kaminaris/GigaESC-TOLT/3DModels/Infineon-PG-TFLGA-13-1_3D_01_STP-Package-v05_00-EN.stp

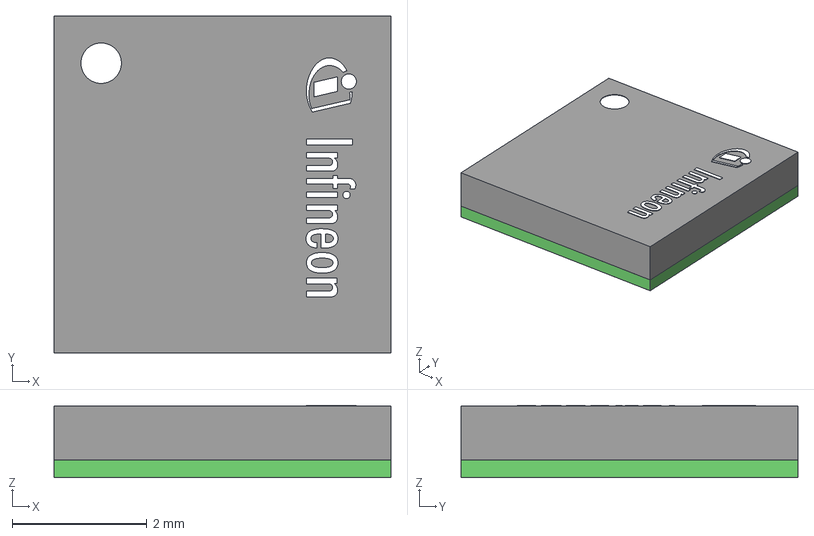
[picture p1: CAD file, 2026-09-26]
3DModels/Infineon-PG-TFLGA-13-1_3D_01_STP-Package-v05_00-EN.stp
5.00 x 5.00 x 1.07 mm
PG-TFLGA-13-1_LOGO
PG-TFLGA-13-1_EXPOSED_LEAD_1
PG-TFLGA-13-1_EXPOSED_LEAD_4
PG-TFLGA-13-1_BOTTOM_SUBSTRATE
