kaminaris/GigaESC-TOLT/3DModels/ACS37030LLZATR-040B3.stp

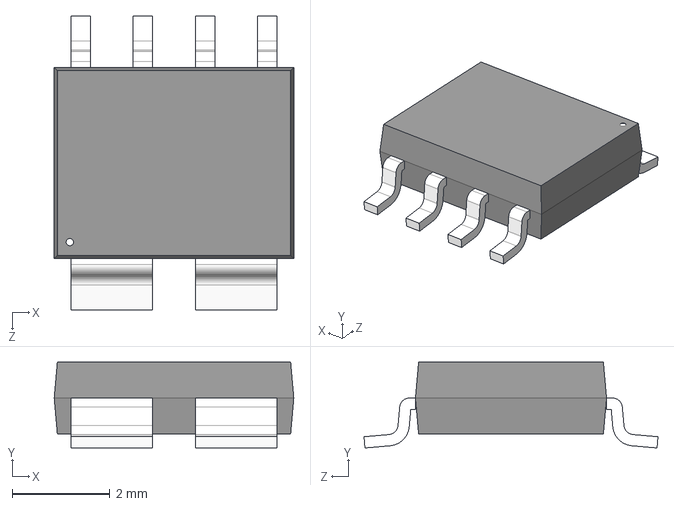
[picture p2: CAD file, 2026-09-26]
3DModels/ACS37030LLZATR-040B3.stp
4.89 x 1.75 x 6.00 mm
