kaminaris/GigaESC-TOLT/GigaTOLT.kicad_pcb

## KiCad design GigaTOLT.kicad_pcb (2026-09-28)

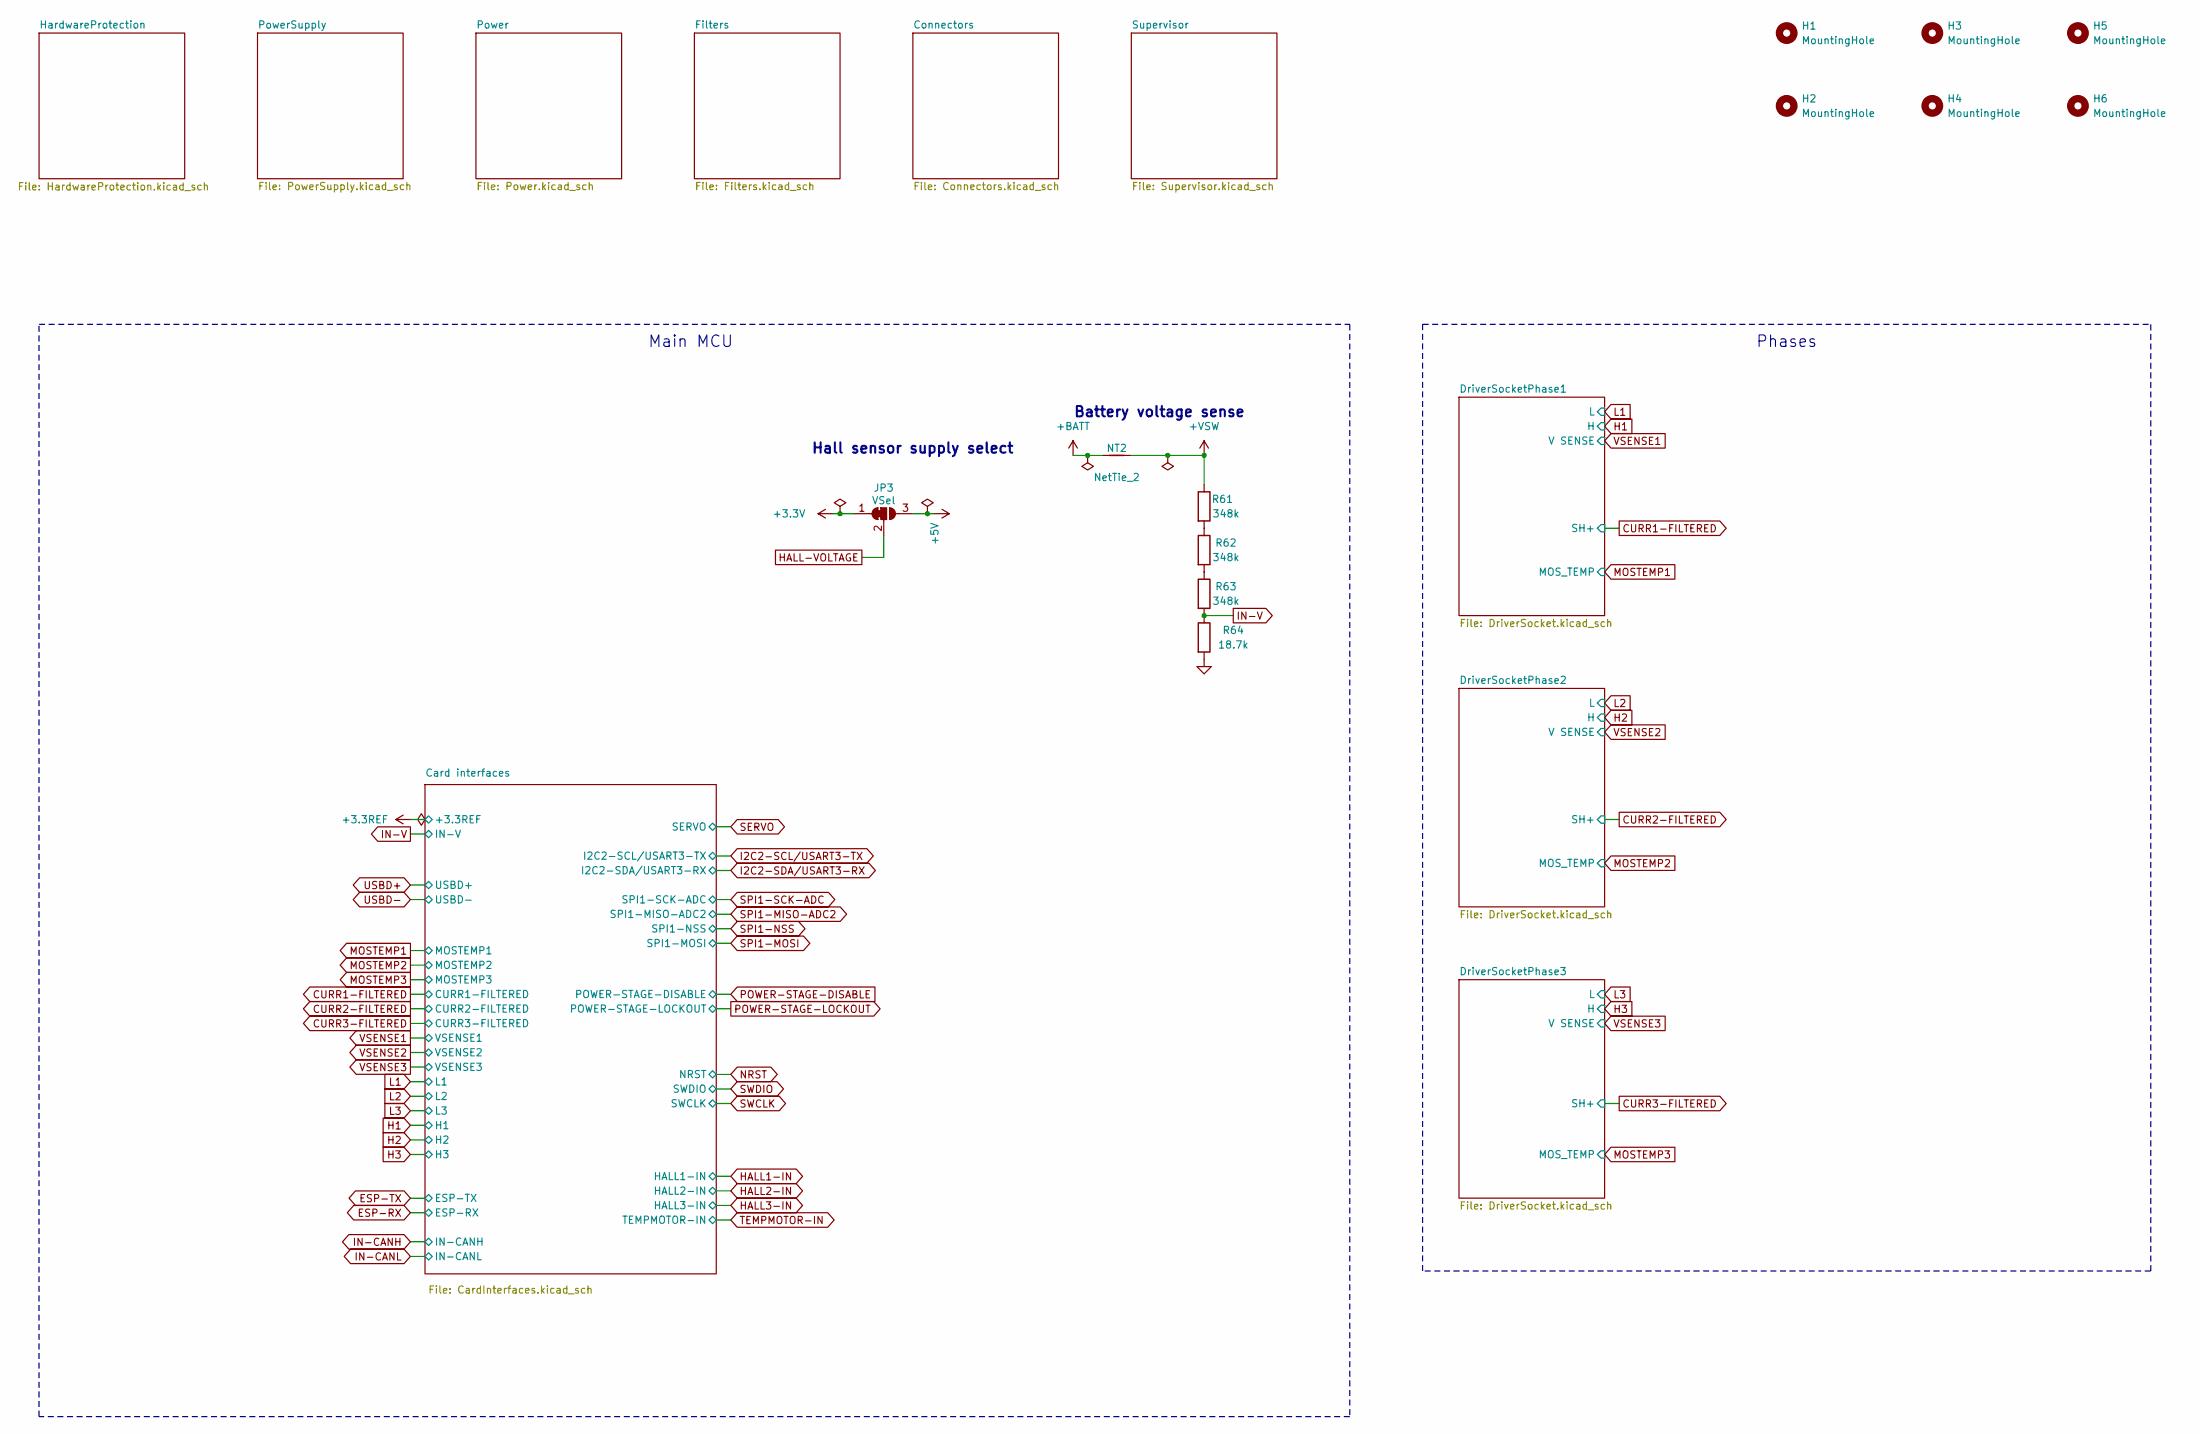
[picture p3: schematic GigaTOLT.kicad_sch]

Parts:
H1, H2, H3, H4, H5, H6: MountingHole; CapHead_3.5mm
JP3: VSel; SolderJumper-3-0.5-Small
NT2: NetTie_2; NetTie-2_SMD_Pad0.5mm
R61, R62, R63: 348k; R_0603_1608Metric; MPN C23006
R64: 18.7k; R_0603_1608Metric; MPN C22893

Connections:
+3.3V: JP3.1 (A); also elsewhere on the board
+5V: JP3.3 (B); also elsewhere on the board
+BATT: NT2.1; also elsewhere on the board
+VSW: NT2.2, R61.1; also elsewhere on the board
GND: R64.2; also elsewhere on the board
HALL-VOLTAGE: JP3.2 (C); also elsewhere on the board
IN-V: R63.2, R64.1; also elsewhere on the board
unnamed: R61.2, R62.1
unnamed: R62.2, R63.1

Notes on the sheet:
Main MCU
Battery voltage sense
Phases
Hall sensor supply select

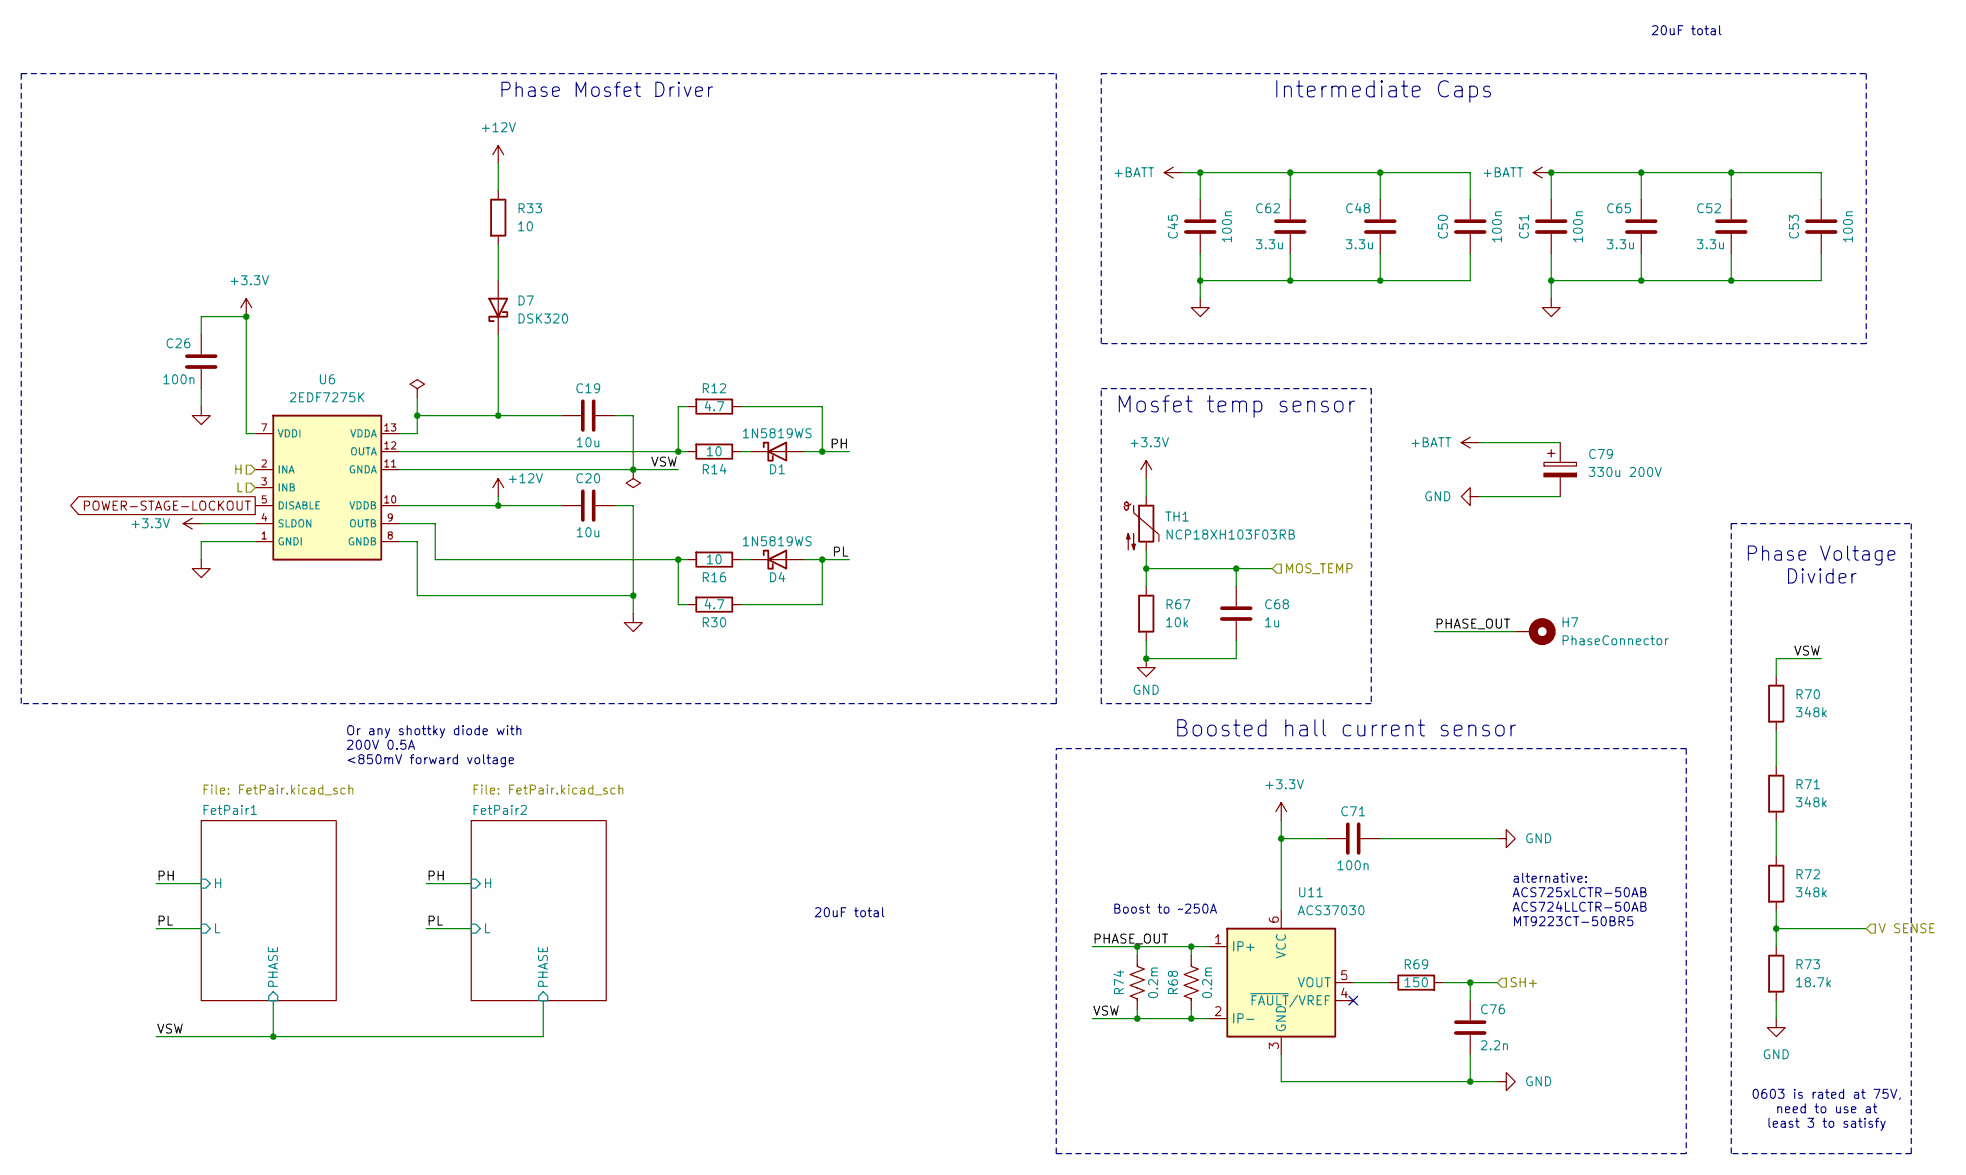
[picture p4: schematic DriverSocket.kicad_sch]

Parts:
C19, C20: 10u; C_0805_2012Metric; MPN C1779; Mouser 81-GRM319R61H475KA2D
C26, C71: 100n; C_0603_1608Metric; MPN C14663; Mouser 187-CL21B104KBFNNNE
C45, C50, C51, C53: 100n; C_0805_2012Metric; MPN C784084
C48, C52, C62, C65: 3.3u; C_2220_5750Metric; MPN C22370027; Mouser 81-GRM32EC72A106KE5K
C68: 1u; C_0603_1608Metric; MPN C15849; Mouser 187-CL21B105KPFNNNE
C76: 2.2n; C_0603_1608Metric; MPN C1604
C79: 330u 200V; CapacitorD18x32; MPN C697601; Mouser 661-EKMR201VS222MR50
D1, D4: 1N5819WS; D_SOD-323_HandSoldering; MPN C191023; Mouser 750-SS520B-HF
D7: DSK320; D_SOD-123; MPN C5290222; Mouser 750-SS520B-HF
H7: PhaseConnector; WP-RAFU_7461112
R12, R30: 4.7; R_0603_1608Metric; MPN C22939; Mouser 603-RC0805JR-072R2L
R14, R16, R33: 10; R_0603_1608Metric; MPN C22939; Mouser 603-RC0805JR-072R2L
R67: 10k; R_0603_1608Metric; MPN C25804; Mouser 708-RNCP0805FTD10K0
R68, R74: 0.2m; R_2512_6332Metric; MPN C4944115
R69: 150; R_0603_1608Metric; MPN C22808
R70, R71, R72: 348k; R_0603_1608Metric; MPN C23006; Mouser 603-RC0805FR-07100KL
R73: 18.7k; R_0603_1608Metric; MPN C22893; Mouser 71-CRCW0805-1.8K-E3
TH1: NCP18XH103F03RB; R_0603_1608Metric; MPN C13564; Mouser 81-NCP18XH103F03RB
U6: 2EDF7275K; IC_2EDF7275KXUMA2; MPN C2677063
U11: ACS37030; SOIC-6_3.9x4.9mm_P1.27mm; MPN C22406095

Connections:
+3.3V: C26.2, C71.2, TH1.1, U6.4 (SLDON), U6.7 (VDDI), U11.6 (VCC); also elsewhere on the board
+12V: C20.1, R33.1, U6.10 (VDDB); also elsewhere on the board
+BATT: C45.1, C48.1, C50.1, C51.1, C52.1, C53.1, C62.1, C65.1, C79.1; also elsewhere on the board
/DriverSocketPhase1/PH: D1.2 (A), R12.1; also elsewhere on the board
/DriverSocketPhase1/PHASE_OUT: H7.1 (1_1), R68.2, R74.2, U11.1 (IP+)
/DriverSocketPhase1/PL: D4.2 (A), R30.1; also elsewhere on the board
/DriverSocketPhase1/VSW: C19.2, R68.1, R70.1, R74.1, U6.11 (GNDA), U11.2 (IP-); also elsewhere on the board
CURR1-FILTERED: C76.1, R69.2; also elsewhere on the board
GND: C20.2, C26.1, C45.2, C48.2, C50.2, C51.2, C52.2, C53.2, C62.2, C65.2, C68.2, C71.1, C76.2, C79.2, R67.2, R73.2, U6.1 (GNDI), U6.8 (GNDB), U11.3 (GND); also elsewhere on the board
H1: U6.2 (INA); also elsewhere on the board
L1: U6.3 (INB); also elsewhere on the board
MOSTEMP1: C68.1, R67.1, TH1.2; also elsewhere on the board
unnamed: D1.1 (K), R14.1
unnamed: D4.1 (K), R16.1
unnamed: D7.2 (A), R33.2
unnamed: C19.1, D7.1 (K), U6.13 (VDDA)
unnamed: R70.2, R71.1
unnamed: R71.2, R72.1
unnamed: R12.2, R14.2, U6.12 (OUTA)
unnamed: R16.2, R30.2, U6.9 (OUTB)
unnamed: R69.1, U11.5 (VOUT)
POWER-STAGE-LOCKOUT: U6.5 (DISABLE); also elsewhere on the board
VSENSE1: R72.2, R73.1; also elsewhere on the board

Parts of its further copies:
C21, C22, C24, C25: 10u; C_0805_2012Metric; MPN C1779; Mouser 81-GRM319R61H475KA2D
C28, C29, C101, C131: 100n; C_0603_1608Metric; MPN C14663; Mouser 187-CL21B104KBFNNNE
C46, C47, C54, C56, C58, C59, C60, C69: 100n; C_0805_2012Metric; MPN C784084
C49, C55, C57, C61, C63, C64, C66, C67: 3.3u; C_2220_5750Metric; MPN C22370027; Mouser 81-GRM32EC72A106KE5K
C98, C128: 1u; C_0603_1608Metric; MPN C15849; Mouser 187-CL21B105KPFNNNE
C106, C136: 2.2n; C_0603_1608Metric; MPN C1604
C109, C139: 330u 200V; CapacitorD18x32; MPN C697601; Mouser 661-EKMR201VS222MR50
D2, D3, D5, D6: 1N5819WS; D_SOD-323_HandSoldering; MPN C191023; Mouser 750-SS520B-HF
D8, D9: DSK320; D_SOD-123; MPN C5290222; Mouser 750-SS520B-HF
H8, H9: PhaseConnector; WP-RAFU_7461112
R13, R15, R31, R32: 4.7; R_0603_1608Metric; MPN C22939; Mouser 603-RC0805JR-072R2L
R20, R29, R36, R37, R38, R39: 10; R_0603_1608Metric; MPN C22939; Mouser 603-RC0805JR-072R2L
R75, R76, R81, R98: 0.2m; R_2512_6332Metric; MPN C4944115
R80, R97: 10k; R_0603_1608Metric; MPN C25804; Mouser 708-RNCP0805FTD10K0
R82, R99: 150; R_0603_1608Metric; MPN C22808
R83, R84, R85, R100, R101, R102: 348k; R_0603_1608Metric; MPN C23006; Mouser 603-RC0805FR-07100KL
R86, R103: 18.7k; R_0603_1608Metric; MPN C22893; Mouser 71-CRCW0805-1.8K-E3
TH2, TH3: NCP18XH103F03RB; R_0603_1608Metric; MPN C13564; Mouser 81-NCP18XH103F03RB
U7, U8: 2EDF7275K; IC_2EDF7275KXUMA2; MPN C2677063
U13, U15: ACS37030; SOIC-6_3.9x4.9mm_P1.27mm; MPN C22406095

Connections of its further copies:
+3.3V: C28.2, C29.2, C101.2, C131.2, TH2.1, TH3.1, U7.4 (SLDON), U7.7 (VDDI), U8.4 (SLDON), U8.7 (VDDI), U13.6 (VCC), U15.6 (VCC); also elsewhere on the board
+12V: C22.1, C25.1, R36.1, R37.1, U7.10 (VDDB), U8.10 (VDDB); also elsewhere on the board
+BATT: C46.1, C47.1, C49.1, C54.1, C55.1, C56.1, C57.1, C58.1, C59.1, C60.1, C61.1, C63.1, C64.1, C66.1, C67.1, C69.1, C109.1, C139.1; also elsewhere on the board
/DriverSocketPhase2/PH: D2.2 (A), R13.1; also elsewhere on the board
/DriverSocketPhase2/PHASE_OUT: H8.1 (1_1), R75.2, R81.2, U13.1 (IP+)
/DriverSocketPhase2/PL: D5.2 (A), R31.1; also elsewhere on the board
/DriverSocketPhase2/VSW: C21.2, R75.1, R81.1, R83.1, U7.11 (GNDA), U13.2 (IP-); also elsewhere on the board
/DriverSocketPhase3/PH: D3.2 (A), R15.1; also elsewhere on the board
/DriverSocketPhase3/PHASE_OUT: H9.1 (1_1), R76.2, R98.2, U15.1 (IP+)
/DriverSocketPhase3/PL: D6.2 (A), R32.1; also elsewhere on the board
/DriverSocketPhase3/VSW: C24.2, R76.1, R98.1, R100.1, U8.11 (GNDA), U15.2 (IP-); also elsewhere on the board
CURR2-FILTERED: C106.1, R82.2; also elsewhere on the board
CURR3-FILTERED: C136.1, R99.2; also elsewhere on the board
GND: C22.2, C25.2, C28.1, C29.1, C46.2, C47.2, C49.2, C54.2, C55.2, C56.2, C57.2, C58.2, C59.2, C60.2, C61.2, C63.2, C64.2, C66.2, C67.2, C69.2, C98.2, C101.1, C106.2, C109.2, C128.2, C131.1, C136.2, C139.2, R80.2, R86.2, R97.2, R103.2, U7.1 (GNDI), U7.8 (GNDB), U8.1 (GNDI), U8.8 (GNDB), U13.3 (GND), U15.3 (GND); also elsewhere on the board
H2: U7.2 (INA); also elsewhere on the board
H3: U8.2 (INA); also elsewhere on the board
L2: U7.3 (INB); also elsewhere on the board
L3: U8.3 (INB); also elsewhere on the board
MOSTEMP2: C98.1, R80.1, TH2.2; also elsewhere on the board
MOSTEMP3: C128.1, R97.1, TH3.2; also elsewhere on the board
unnamed: D2.1 (K), R38.1
unnamed: D3.1 (K), R39.1
unnamed: D5.1 (K), R20.1
unnamed: D6.1 (K), R29.1
unnamed: D8.2 (A), R36.2
unnamed: C21.1, D8.1 (K), U7.13 (VDDA)
unnamed: D9.2 (A), R37.2
unnamed: C24.1, D9.1 (K), U8.13 (VDDA)
unnamed: R83.2, R84.1
unnamed: R84.2, R85.1
unnamed: R100.2, R101.1
unnamed: R101.2, R102.1
unnamed: R13.2, R38.2, U7.12 (OUTA)
unnamed: R20.2, R31.2, U7.9 (OUTB)
unnamed: R15.2, R39.2, U8.12 (OUTA)
unnamed: R29.2, R32.2, U8.9 (OUTB)
unnamed: R82.1, U13.5 (VOUT)
unnamed: R99.1, U15.5 (VOUT)
POWER-STAGE-LOCKOUT: U7.5 (DISABLE), U8.5 (DISABLE); also elsewhere on the board
VSENSE2: R85.2, R86.1; also elsewhere on the board
VSENSE3: R102.2, R103.1; also elsewhere on the board

Notes on the sheet:
20uF total
Phase Mosfet Driver
alternative: ACS725xLCTR-50AB ACS724LLCTR-50AB MT9223CT-50BR5
0603 is rated at 75V, need to use at least 3 to satisfy
Boosted hall current sensor
Phase Voltage Divider
Mosfet temp sensor
Boost to ~250A
Or any shottky diode with 200V 0.5A <850mV forward voltage
Intermediate Caps

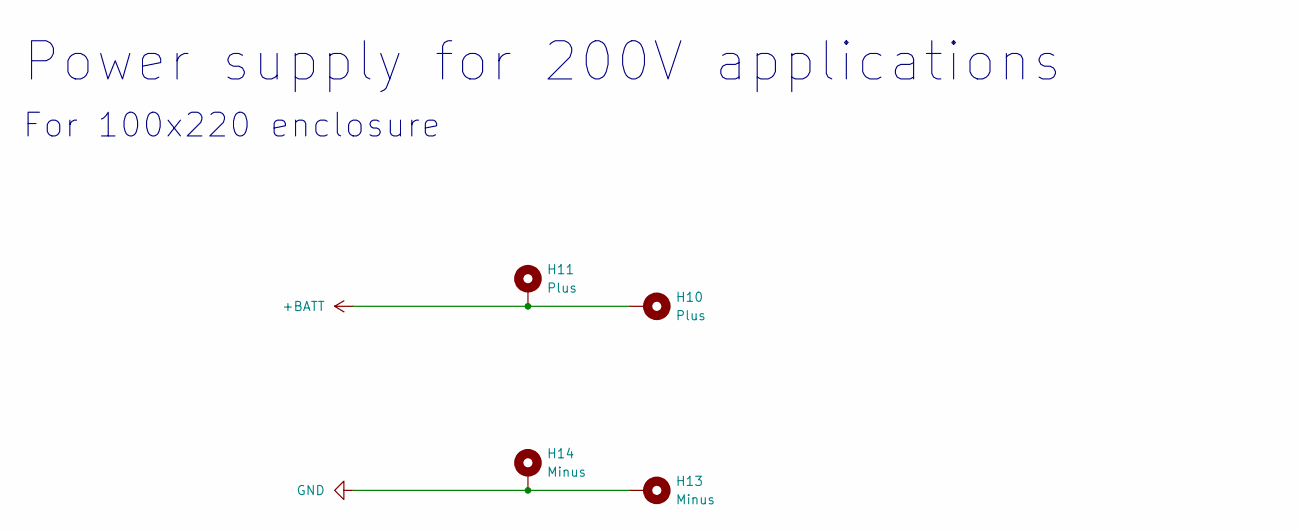
[picture p5: schematic PowerSupply.kicad_sch]

Parts:
H10: Plus; WP-RAFU_7461112
H11: Plus; BusBar_5x2mm_L90
H13: Minus; WP-RAFU_7461112
H14: Minus; BusBar_5x2mm_L90

Connections:
+BATT: H10.1 (1_1), H11.1 (1_1); also elsewhere on the board
GND: H13.1 (1_1), H14.1 (1_1); also elsewhere on the board

Notes on the sheet:
Power supply for 200V applications
For 100x220 enclosure

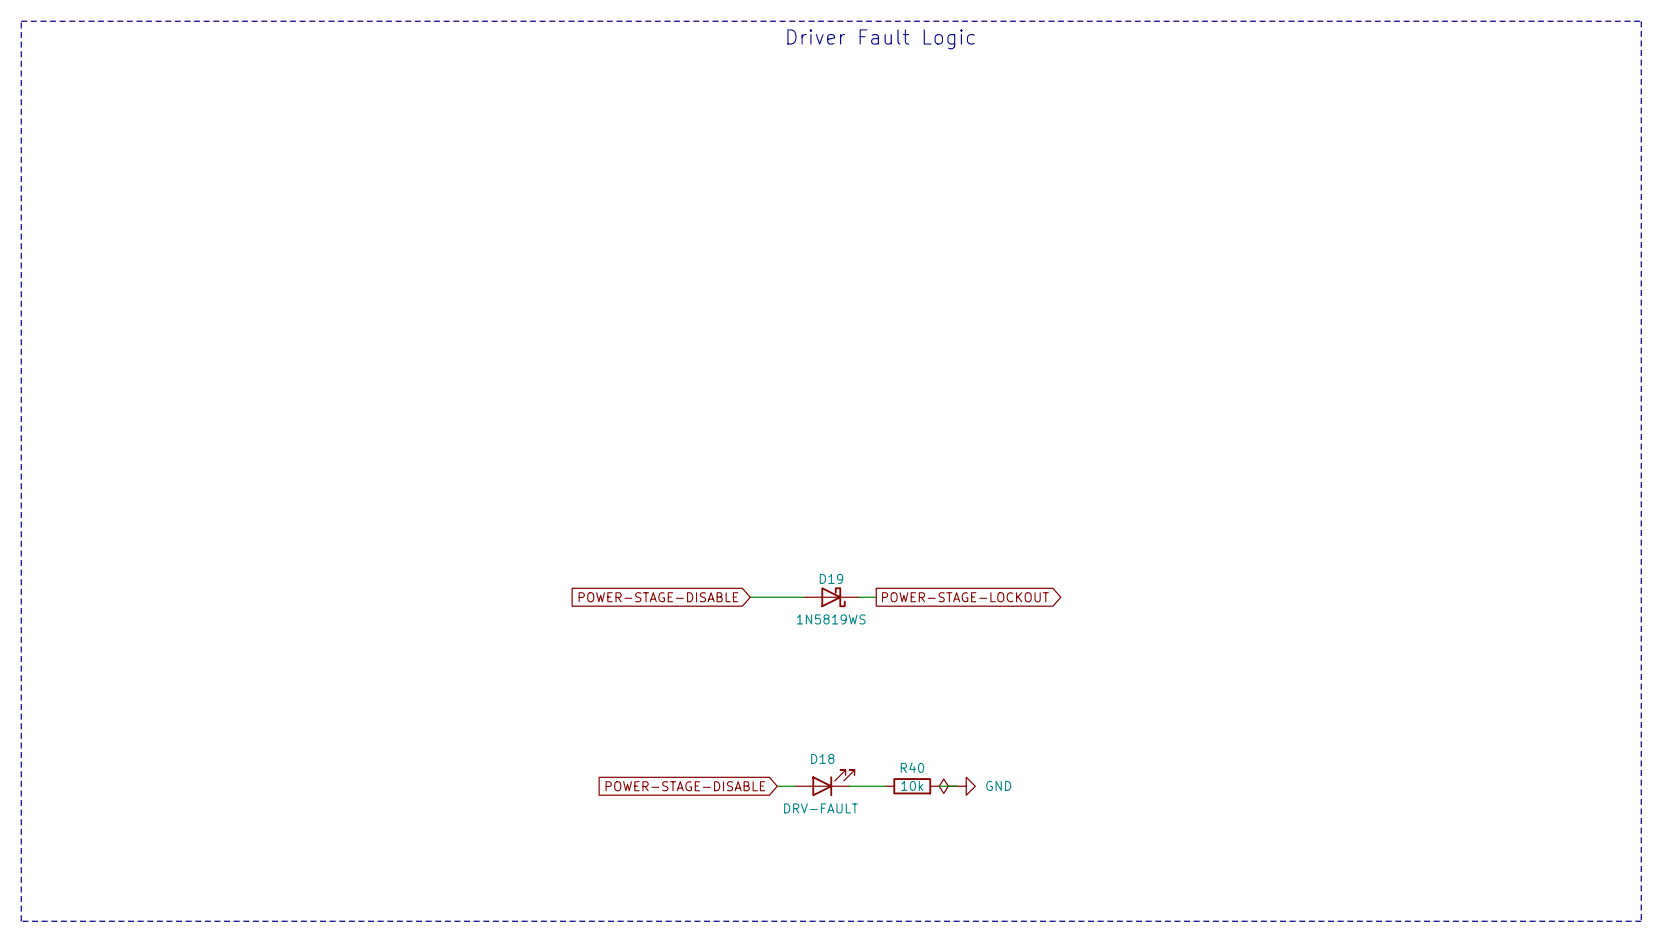
[picture p6: schematic HardwareProtection.kicad_sch]

Parts:
D18: DRV-FAULT; LED_0603_1608Metric; MPN C2286
D19: 1N5819WS; D_SOD-323_HandSoldering; MPN C191023
R40: 10k; R_0603_1608Metric; MPN C25804

Connections:
GND: R40.2; also elsewhere on the board
unnamed: D18.1 (K), R40.1
POWER-STAGE-DISABLE: D18.2 (A), D19.2 (A); also elsewhere on the board
POWER-STAGE-LOCKOUT: D19.1 (K); also elsewhere on the board

Notes on the sheet:
Driver Fault Logic

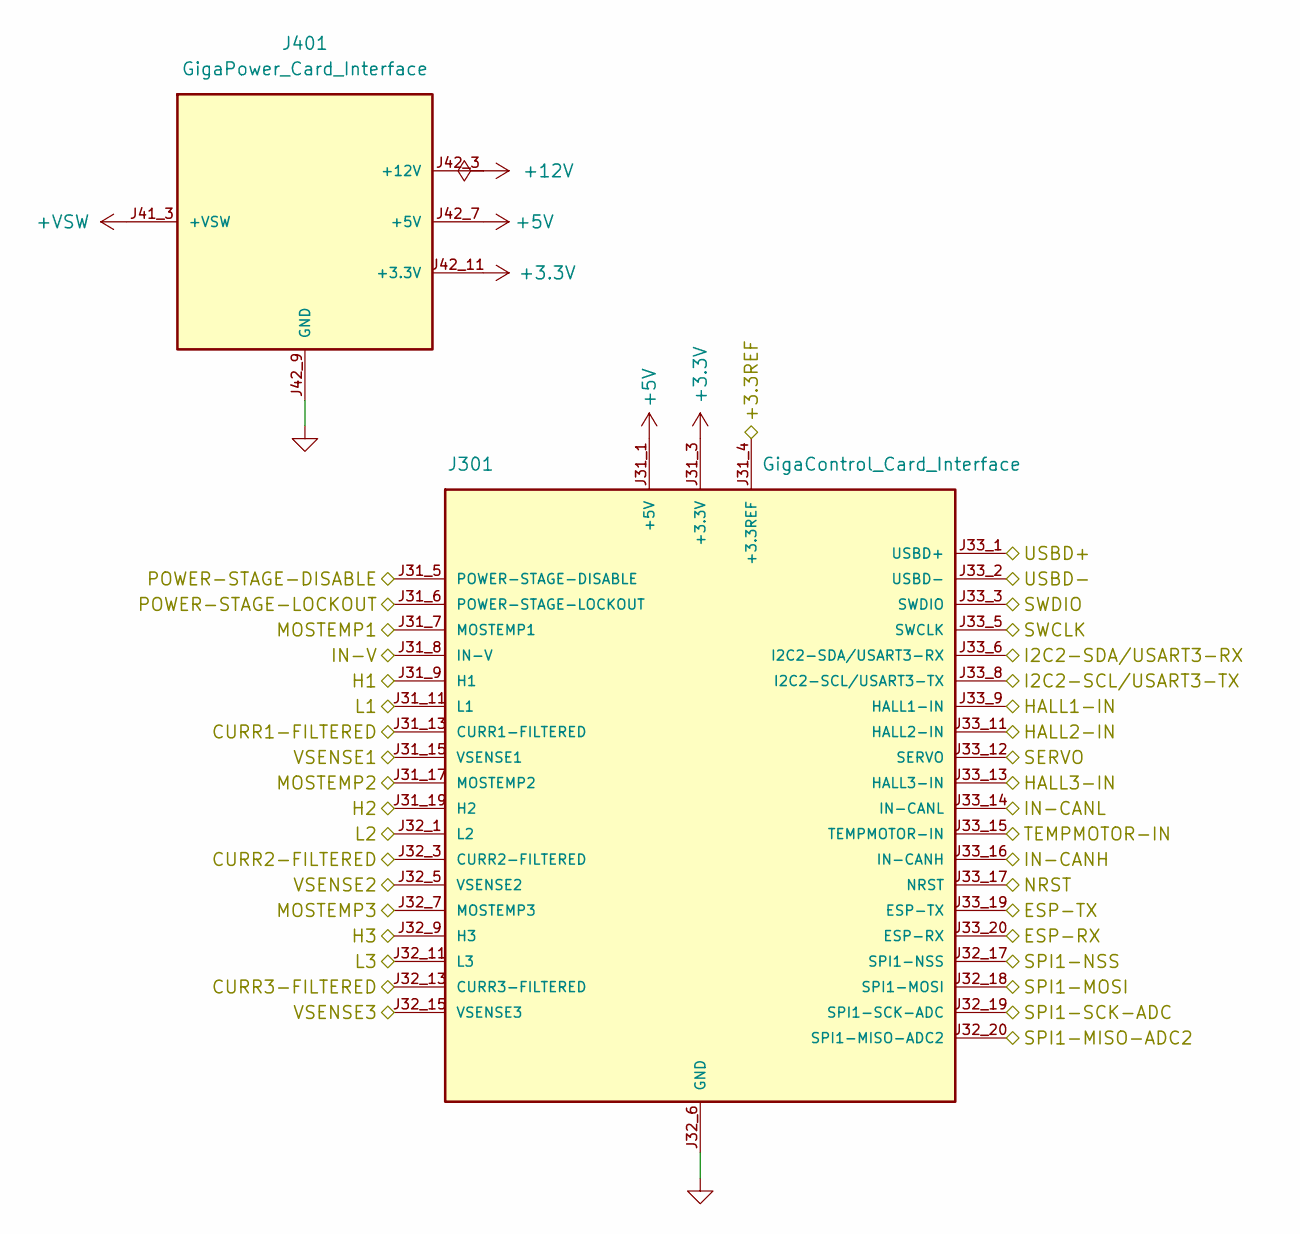
[picture p7: schematic CardInterfaces.kicad_sch]

Parts:
J301: GigaControl_Card_Interface
J401: GigaPower_Card_Interface

Connections:
+3.3REF: J301.J31_4 (+3.3REF)
+3.3V: J301.J31_3 (+3.3V), J401.J42_11 (+3.3V), J401.J42_12 (+3.3V); also elsewhere on the board
+5V: J301.J31_1 (+5V), J401.J42_7 (+5V), J401.J42_8 (+5V); also elsewhere on the board
+12V: J401.J42_3 (+12V), J401.J42_4 (+12V); also elsewhere on the board
+VSW: J401.J41_3 (+VSW), J401.J41_5 (+VSW); also elsewhere on the board
CURR1-FILTERED: J301.J31_13 (CURR1-FILTERED); also elsewhere on the board
CURR2-FILTERED: J301.J32_3 (CURR2-FILTERED); also elsewhere on the board
CURR3-FILTERED: J301.J32_13 (CURR3-FILTERED); also elsewhere on the board
ESP-RX: J301.J33_20 (ESP-RX); also elsewhere on the board
ESP-TX: J301.J33_19 (ESP-TX); also elsewhere on the board
GND: J301.J31_2 (GND), J301.J31_10 (GND), J301.J31_12 (GND), J301.J31_14 (GND), J301.J31_16 (GND), J301.J31_18 (GND), J301.J31_20 (GND), J301.J32_2 (GND), J301.J32_4 (GND), J301.J32_6 (GND), J301.J32_8 (GND), J301.J32_10 (GND), J301.J32_12 (GND), J301.J32_14 (GND), J301.J32_16 (GND), J301.J33_4 (GND), J301.J33_7 (GND), J301.J33_10 (GND), J301.J33_18 (GND), J401.J41_17 (GND), J401.J41_18 (GND), J401.J41_19 (GND), J401.J41_20 (GND), J401.J42_1 (GND), J401.J42_2 (GND), J401.J42_5 (GND), J401.J42_6 (GND), J401.J42_9 (GND), J401.J42_10 (GND), J401.J42_13 (GND), J401.J42_14 (GND), J401.J42_15 (GND), J401.J42_16 (GND), J401.J42_19 (GND), J401.J42_20 (GND); also elsewhere on the board
H1: J301.J31_9 (H1); also elsewhere on the board
H2: J301.J31_19 (H2); also elsewhere on the board
H3: J301.J32_9 (H3); also elsewhere on the board
HALL1-IN: J301.J33_9 (HALL1-IN); also elsewhere on the board
HALL2-IN: J301.J33_11 (HALL2-IN); also elsewhere on the board
HALL3-IN: J301.J33_13 (HALL3-IN); also elsewhere on the board
I2C2-SCL/USART3-TX: J301.J33_8 (I2C2-SCL/USART3-TX); also elsewhere on the board
I2C2-SDA/USART3-RX: J301.J33_6 (I2C2-SDA/USART3-RX); also elsewhere on the board
IN-CANH: J301.J33_16 (IN-CANH); also elsewhere on the board
IN-CANL: J301.J33_14 (IN-CANL); also elsewhere on the board
IN-V: J301.J31_8 (IN-V); also elsewhere on the board
L1: J301.J31_11 (L1); also elsewhere on the board
L2: J301.J32_1 (L2); also elsewhere on the board
L3: J301.J32_11 (L3); also elsewhere on the board
MOSTEMP1: J301.J31_7 (MOSTEMP1); also elsewhere on the board
MOSTEMP2: J301.J31_17 (MOSTEMP2); also elsewhere on the board
MOSTEMP3: J301.J32_7 (MOSTEMP3); also elsewhere on the board
NRST: J301.J33_17 (NRST); also elsewhere on the board
POWER-STAGE-DISABLE: J301.J31_5 (POWER-STAGE-DISABLE); also elsewhere on the board
POWER-STAGE-LOCKOUT: J301.J31_6 (POWER-STAGE-LOCKOUT); also elsewhere on the board
SERVO: J301.J33_12 (SERVO); also elsewhere on the board
SPI1-MISO-ADC2: J301.J32_20 (SPI1-MISO-ADC2); also elsewhere on the board
SPI1-MOSI: J301.J32_18 (SPI1-MOSI); also elsewhere on the board
SPI1-NSS: J301.J32_17 (SPI1-NSS); also elsewhere on the board
SPI1-SCK-ADC: J301.J32_19 (SPI1-SCK-ADC); also elsewhere on the board
SWCLK: J301.J33_5 (SWCLK); also elsewhere on the board
SWDIO: J301.J33_3 (SWDIO); also elsewhere on the board
TEMPMOTOR-IN: J301.J33_15 (TEMPMOTOR-IN); also elsewhere on the board
USBD+: J301.J33_1 (USBD+); also elsewhere on the board
USBD-: J301.J33_2 (USBD-); also elsewhere on the board
VSENSE1: J301.J31_15 (VSENSE1); also elsewhere on the board
VSENSE2: J301.J32_5 (VSENSE2); also elsewhere on the board
VSENSE3: J301.J32_15 (VSENSE3); also elsewhere on the board

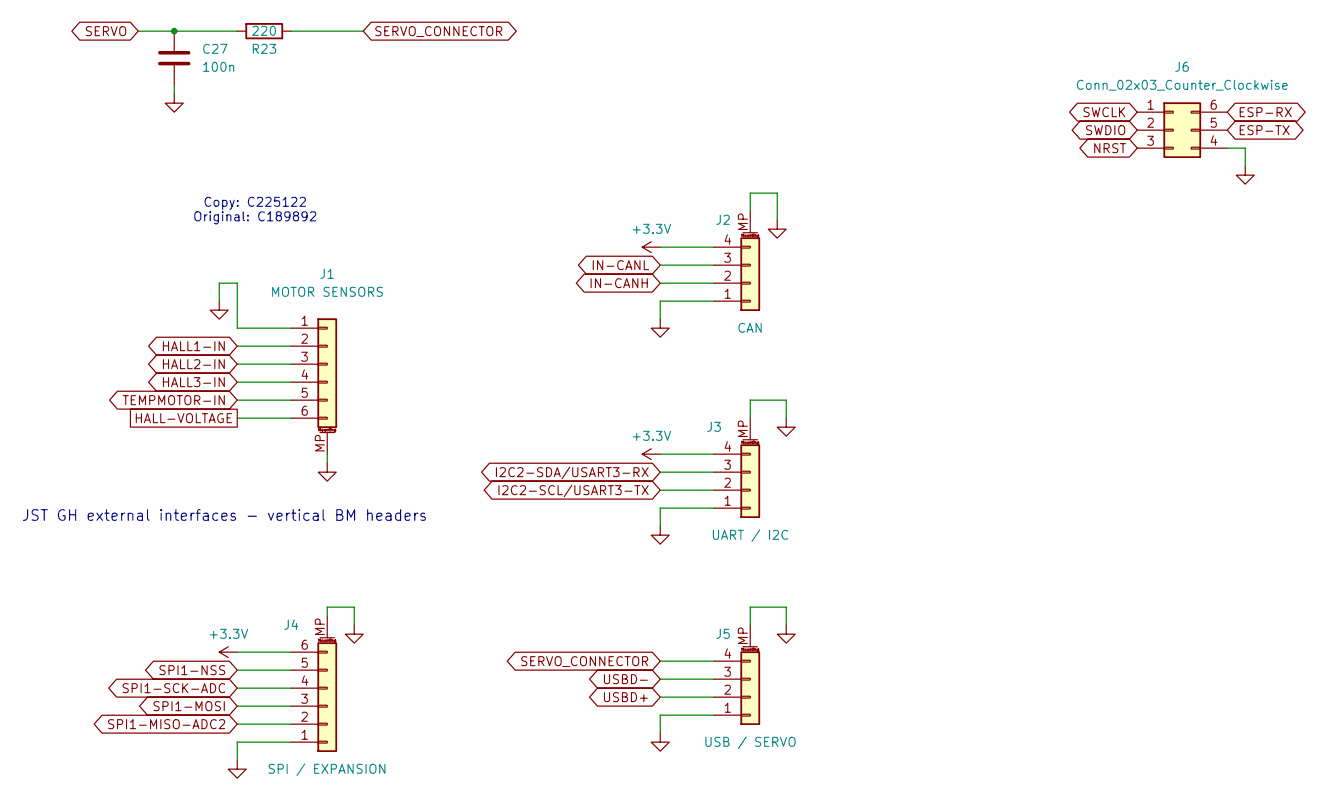
[picture p8: schematic Connectors.kicad_sch]

Parts:
C27: 100n; C_0402_1005Metric; MPN C1525
J1: MOTOR SENSORS; JST_GH_BM06B-GHS-TBT_1x06-1MP_P1.25mm_Vertical; MPN C225122
J2: CAN; JST_GH_BM04B-GHS-TBT_1x04-1MP_P1.25mm_Vertical; MPN C161692
J3: UART / I2C; JST_GH_BM04B-GHS-TBT_1x04-1MP_P1.25mm_Vertical; MPN C161692
J4: SPI / EXPANSION; JST_GH_BM06B-GHS-TBT_1x06-1MP_P1.25mm_Vertical; MPN C225122
J5: USB / SERVO; JST_GH_BM04B-GHS-TBT_1x04-1MP_P1.25mm_Vertical; MPN C161692
J6: Conn_02x03_Counter_Clockwise; PinHeader_2x03_P1.00mm_Vertical; MPN C22438180
R23: 220; R_0603_1608Metric; MPN C22962

Connections:
+3.3V: J2.4, J3.4, J4.6; also elsewhere on the board
ESP-RX: J6.6; also elsewhere on the board
ESP-TX: J6.5; also elsewhere on the board
GND: C27.2, J1.1, J1.MP (MountPin), J2.1, J2.MP (MountPin), J3.1, J3.MP (MountPin), J4.1, J4.MP (MountPin), J5.1, J5.MP (MountPin), J6.4; also elsewhere on the board
HALL1-IN: J1.2; also elsewhere on the board
HALL2-IN: J1.3; also elsewhere on the board
HALL3-IN: J1.4; also elsewhere on the board
HALL-VOLTAGE: J1.6; also elsewhere on the board
I2C2-SCL/USART3-TX: J3.2; also elsewhere on the board
I2C2-SDA/USART3-RX: J3.3; also elsewhere on the board
IN-CANH: J2.2; also elsewhere on the board
IN-CANL: J2.3; also elsewhere on the board
NRST: J6.3; also elsewhere on the board
SERVO: C27.1, R23.2; also elsewhere on the board
SERVO_CONNECTOR: J5.4, R23.1
SPI1-MISO-ADC2: J4.2; also elsewhere on the board
SPI1-MOSI: J4.3; also elsewhere on the board
SPI1-NSS: J4.5; also elsewhere on the board
SPI1-SCK-ADC: J4.4; also elsewhere on the board
SWCLK: J6.1; also elsewhere on the board
SWDIO: J6.2; also elsewhere on the board
TEMPMOTOR-IN: J1.5; also elsewhere on the board
USBD+: J5.2; also elsewhere on the board
USBD-: J5.3; also elsewhere on the board

Notes on the sheet:
Copy: C225122 Original: C189892
JST GH external interfaces - vertical BM headers

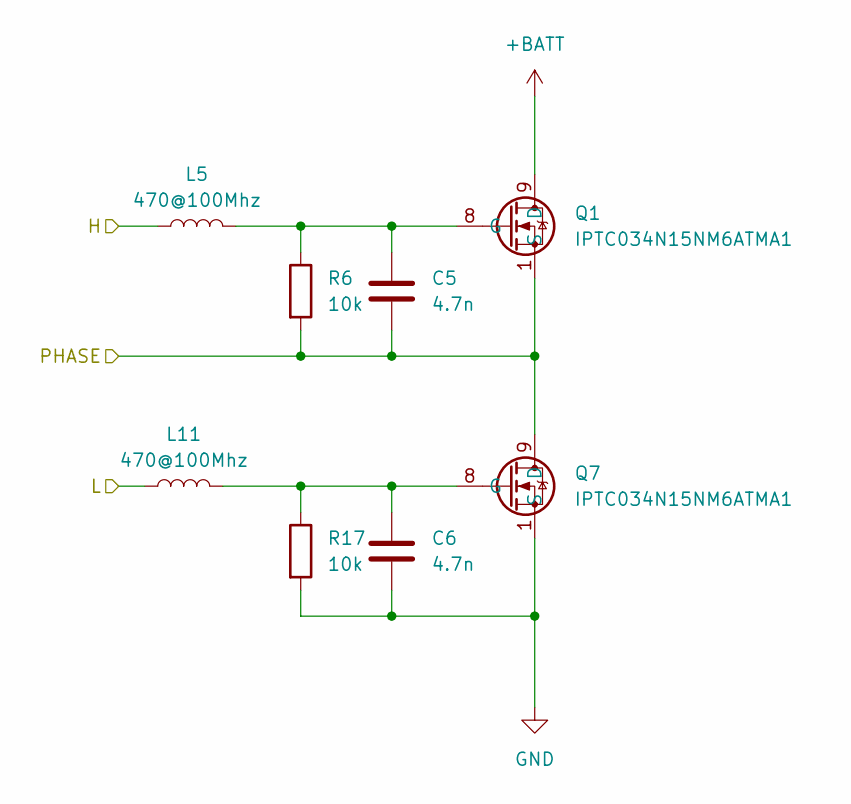
[picture p9: schematic FetPair.kicad_sch]

Parts:
C5, C6: 4.7n; C_0603_1608Metric; MPN C53987
L5, L11: 470@100Mhz; L_0603_1608Metric; MPN C113019
Q1, Q7: IPTC034N15NM6ATMA1; TOLT; MPN C3280341
R6, R17: 10k; R_0603_1608Metric; MPN C25804; Mouser 708-RNCP0805FTD10K0

Connections:
+BATT: Q1.9 (D), Q1.10 (D_2), Q1.11 (D_3), Q1.12 (D_4), Q1.13 (D_5), Q1.14 (D_6), Q1.15 (D_7), Q1.16 (D_8); also elsewhere on the board
/DriverSocketPhase1/PH: L5.1; also elsewhere on the board
/DriverSocketPhase1/PL: L11.1; also elsewhere on the board
/DriverSocketPhase1/VSW: C5.2, Q1.1 (S), Q1.2 (S_2), Q1.3 (S_3), Q1.4 (S_4), Q1.5 (S_5), Q1.6 (S_6), Q1.7 (S_7), Q7.9 (D), Q7.10 (D_2), Q7.11 (D_3), Q7.12 (D_4), Q7.13 (D_5), Q7.14 (D_6), Q7.15 (D_7), Q7.16 (D_8), R6.2; also elsewhere on the board
GND: C6.2, Q7.1 (S), Q7.2 (S_2), Q7.3 (S_3), Q7.4 (S_4), Q7.5 (S_5), Q7.6 (S_6), Q7.7 (S_7), R17.2; also elsewhere on the board
unnamed: C5.1, L5.2, Q1.8 (G), R6.1
unnamed: C6.1, L11.2, Q7.8 (G), R17.1

Parts of its further copies:
C10, C11, C12, C13, C14, C15, C16, C17, C18, C23: 4.7n; C_0603_1608Metric; MPN C53987
L9, L10, L12, L13, L14, L15, L16, L17, L18, L19: 470@100Mhz; L_0603_1608Metric; MPN C113019
Q2, Q3, Q5, Q6, Q8, Q9, Q10, Q23, Q24, Q25: IPTC034N15NM6ATMA1; TOLT; MPN C3280341
R7, R8, R18, R19, R24, R25, R26, R27, R28, R35: 10k; R_0603_1608Metric; MPN C25804; Mouser 708-RNCP0805FTD10K0

Connections of its further copies:
+BATT: Q2.9 (D), Q2.10 (D_2), Q2.11 (D_3), Q2.12 (D_4), Q2.13 (D_5), Q2.14 (D_6), Q2.15 (D_7), Q2.16 (D_8), Q3.9 (D), Q3.10 (D_2), Q3.11 (D_3), Q3.12 (D_4), Q3.13 (D_5), Q3.14 (D_6), Q3.15 (D_7), Q3.16 (D_8), Q5.9 (D), Q5.10 (D_2), Q5.11 (D_3), Q5.12 (D_4), Q5.13 (D_5), Q5.14 (D_6), Q5.15 (D_7), Q5.16 (D_8), Q6.9 (D), Q6.10 (D_2), Q6.11 (D_3), Q6.12 (D_4), Q6.13 (D_5), Q6.14 (D_6), Q6.15 (D_7), Q6.16 (D_8), Q10.9 (D), Q10.10 (D_2), Q10.11 (D_3), Q10.12 (D_4), Q10.13 (D_5), Q10.14 (D_6), Q10.15 (D_7), Q10.16 (D_8); also elsewhere on the board
/DriverSocketPhase1/PH: L14.1; also elsewhere on the board
/DriverSocketPhase1/PL: L15.1; also elsewhere on the board
/DriverSocketPhase1/VSW: C15.2, Q5.1 (S), Q5.2 (S_2), Q5.3 (S_3), Q5.4 (S_4), Q5.5 (S_5), Q5.6 (S_6), Q5.7 (S_7), Q23.9 (D), Q23.10 (D_2), Q23.11 (D_3), Q23.12 (D_4), Q23.13 (D_5), Q23.14 (D_6), Q23.15 (D_7), Q23.16 (D_8), R26.2; also elsewhere on the board
/DriverSocketPhase2/PH: L9.1, L18.1; also elsewhere on the board
/DriverSocketPhase2/PL: L12.1, L16.1; also elsewhere on the board
/DriverSocketPhase2/VSW: C10.2, C17.2, Q2.1 (S), Q2.2 (S_2), Q2.3 (S_3), Q2.4 (S_4), Q2.5 (S_5), Q2.6 (S_6), Q2.7 (S_7), Q6.1 (S), Q6.2 (S_2), Q6.3 (S_3), Q6.4 (S_4), Q6.5 (S_5), Q6.6 (S_6), Q6.7 (S_7), Q8.9 (D), Q8.10 (D_2), Q8.11 (D_3), Q8.12 (D_4), Q8.13 (D_5), Q8.14 (D_6), Q8.15 (D_7), Q8.16 (D_8), Q24.9 (D), Q24.10 (D_2), Q24.11 (D_3), Q24.12 (D_4), Q24.13 (D_5), Q24.14 (D_6), Q24.15 (D_7), Q24.16 (D_8), R7.2, R27.2; also elsewhere on the board
/DriverSocketPhase3/PH: L10.1, L19.1; also elsewhere on the board
/DriverSocketPhase3/PL: L13.1, L17.1; also elsewhere on the board
/DriverSocketPhase3/VSW: C12.2, C23.2, Q3.1 (S), Q3.2 (S_2), Q3.3 (S_3), Q3.4 (S_4), Q3.5 (S_5), Q3.6 (S_6), Q3.7 (S_7), Q9.9 (D), Q9.10 (D_2), Q9.11 (D_3), Q9.12 (D_4), Q9.13 (D_5), Q9.14 (D_6), Q9.15 (D_7), Q9.16 (D_8), Q10.1 (S), Q10.2 (S_2), Q10.3 (S_3), Q10.4 (S_4), Q10.5 (S_5), Q10.6 (S_6), Q10.7 (S_7), Q25.9 (D), Q25.10 (D_2), Q25.11 (D_3), Q25.12 (D_4), Q25.13 (D_5), Q25.14 (D_6), Q25.15 (D_7), Q25.16 (D_8), R8.2, R28.2; also elsewhere on the board
GND: C11.2, C13.2, C14.2, C16.2, C18.2, Q8.1 (S), Q8.2 (S_2), Q8.3 (S_3), Q8.4 (S_4), Q8.5 (S_5), Q8.6 (S_6), Q8.7 (S_7), Q9.1 (S), Q9.2 (S_2), Q9.3 (S_3), Q9.4 (S_4), Q9.5 (S_5), Q9.6 (S_6), Q9.7 (S_7), Q23.1 (S), Q23.2 (S_2), Q23.3 (S_3), Q23.4 (S_4), Q23.5 (S_5), Q23.6 (S_6), Q23.7 (S_7), Q24.1 (S), Q24.2 (S_2), Q24.3 (S_3), Q24.4 (S_4), Q24.5 (S_5), Q24.6 (S_6), Q24.7 (S_7), Q25.1 (S), Q25.2 (S_2), Q25.3 (S_3), Q25.4 (S_4), Q25.5 (S_5), Q25.6 (S_6), Q25.7 (S_7), R18.2, R19.2, R24.2, R25.2, R35.2; also elsewhere on the board
unnamed: C10.1, L9.2, Q2.8 (G), R7.1
unnamed: C12.1, L10.2, Q3.8 (G), R8.1
unnamed: C15.1, L14.2, Q5.8 (G), R26.1
unnamed: C17.1, L18.2, Q6.8 (G), R27.1
unnamed: C11.1, L12.2, Q8.8 (G), R18.1
unnamed: C13.1, L13.2, Q9.8 (G), R19.1
unnamed: C23.1, L19.2, Q10.8 (G), R28.1
unnamed: C16.1, L15.2, Q23.8 (G), R24.1
unnamed: C18.1, L16.2, Q24.8 (G), R25.1
unnamed: C14.1, L17.2, Q25.8 (G), R35.1
