kaminaris/GigaESC-TOLT/GigaTOLT.kicad_pcb

## KiCad design GigaTOLT.kicad_pcb (continued)

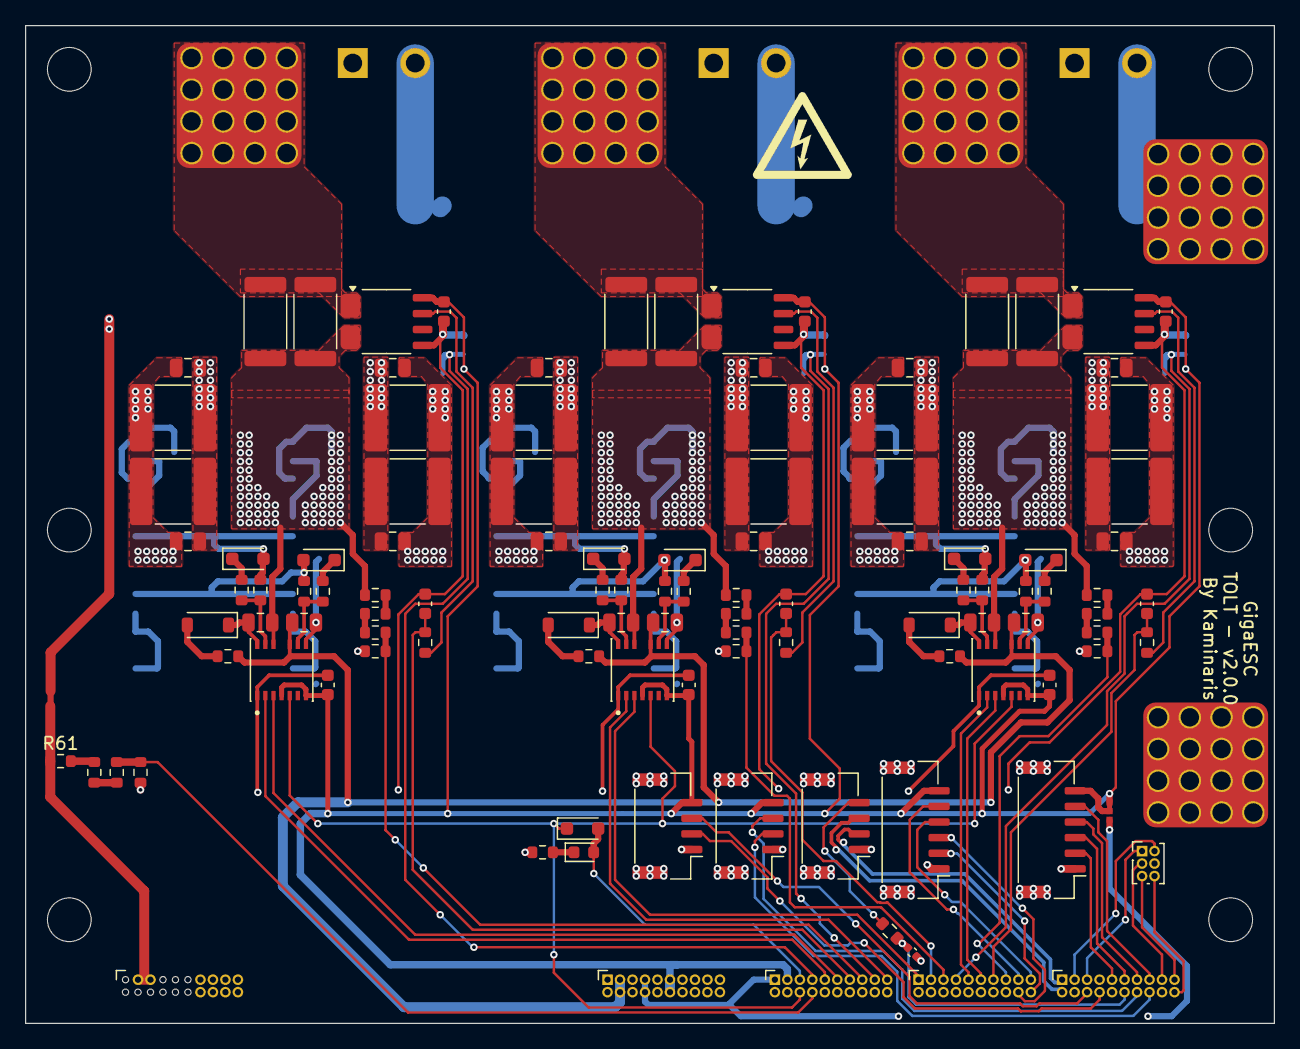
[picture p10: board GigaTOLT.kicad_pcb from above]

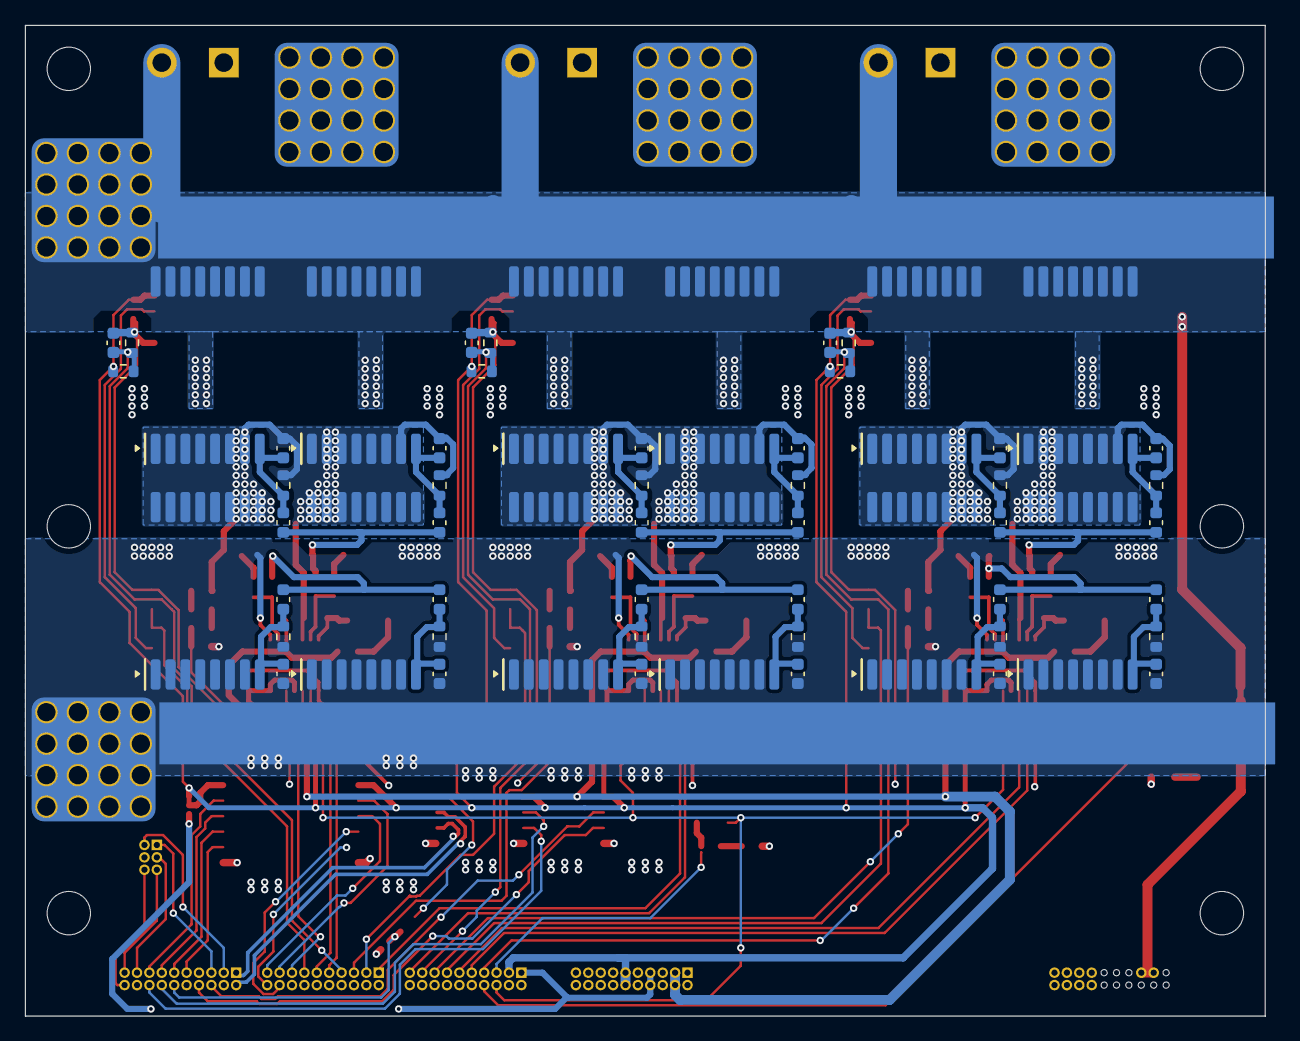
[picture p11: board GigaTOLT.kicad_pcb from below]

Board: 4 copper layers, 100.0 x 79.9 mm, 182 parts (59 on the bottom side), 100 nets.
